Gunasaikiran/FSS_BASED_ABSORBER/README.md

# FSS Based Absorber
This Project presents a novel design for a 3-D printed conformal absorber
based on frequency selective surface (FSS) concept, which exhibits excellent
broadband performance and flexibility. The absorber incorporates an innovative
design element printed on a PLA dielectric, supported by a perforated substrate and
an air gap, that makes it lightweight while maintaining high absorptivity. Resistive
ink is used to print the design pattern on the PLA substrate and a comprehensive
parametric analysis is carried out through simulation to meticulously evaluate each
design parameter’s impact. The geometry demonstrates a remarkable absorption
bandwidth covering frequencies from 8.5 GHz to 29.2 GHz (having a fractional
bandwidth of 109.81%), with absorption levels consistently exceeding 90%. The
design offers broad coverage, spanning the X, Ku, and K bands, and exhibits
polarization insensitivity, ensuring effectiveness across various incident wave
polarizations. Additionally, the absorber remains stable under oblique incidence for
both transverse electric (TE) and transverse magnetic (TM) modes up to 45 degrees
of incident angle, making it ideal for a range of practical applications that require
conformal and flexible electromagnetic absorption. An equivalent circuit model is
created as well as surface current distributions are studied to understand the
mechanism of the proposed absorber in detail. Finally, the absorber has been
fabricated using a low-cost 3-D printing technology and the measured results has
been demonstrated that aligns well with the simulated ones. <br>

<h4>Softwares Used:</h4>
<li>CST and HFSS: Design and Simulation of Absorber</li>
<li>ADS: Design of Equivalent Circuit</li>
<li>MATLAB: Plotting data</li><br>

1]Circuit Geometry:
<p align="center">
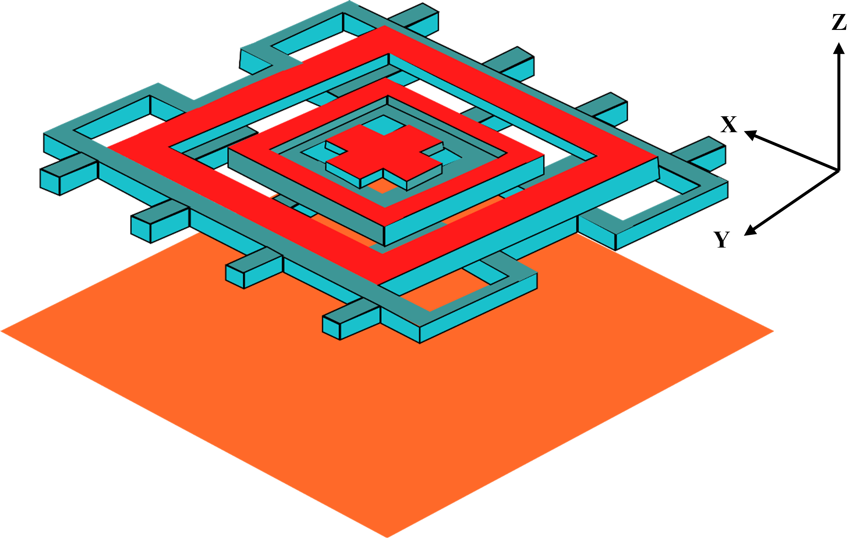
[picture p1: THESIS&PPT/README_PICTURES/3d_with_axis.png]
  
</p>

2]FW:
<p align="center">
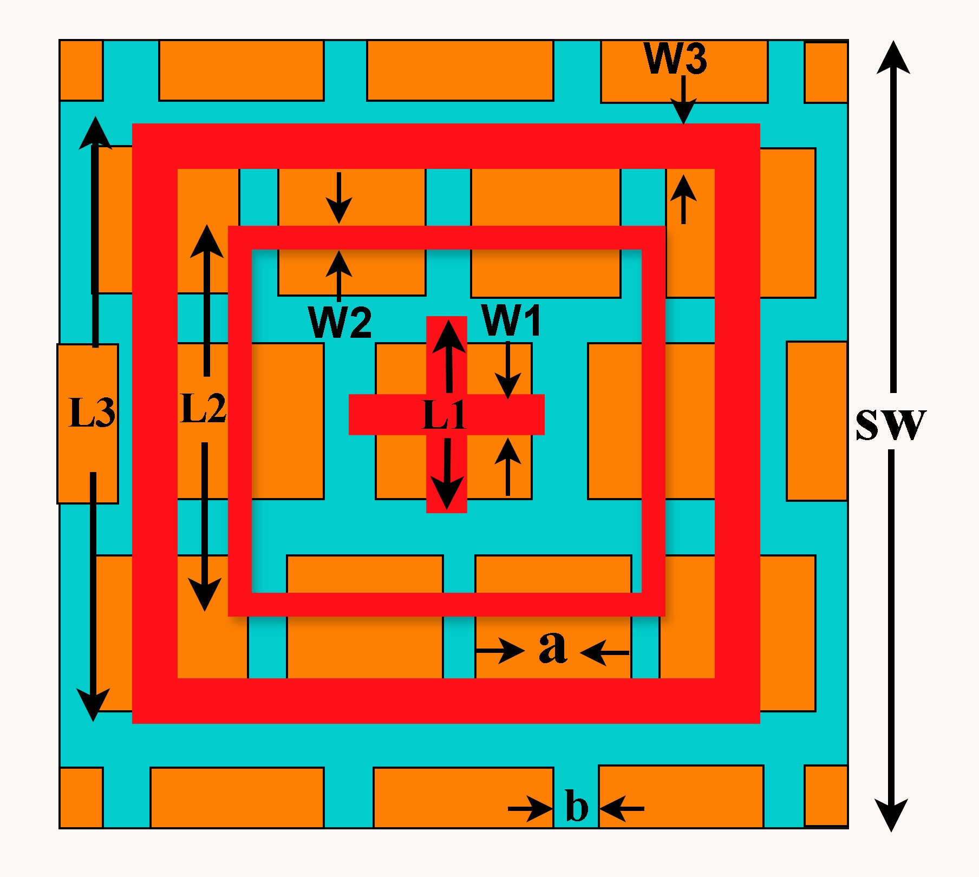
[picture p2: THESIS&PPT/README_PICTURES/FW.jpg]
  
</p>

3]SW:
<p align="center">
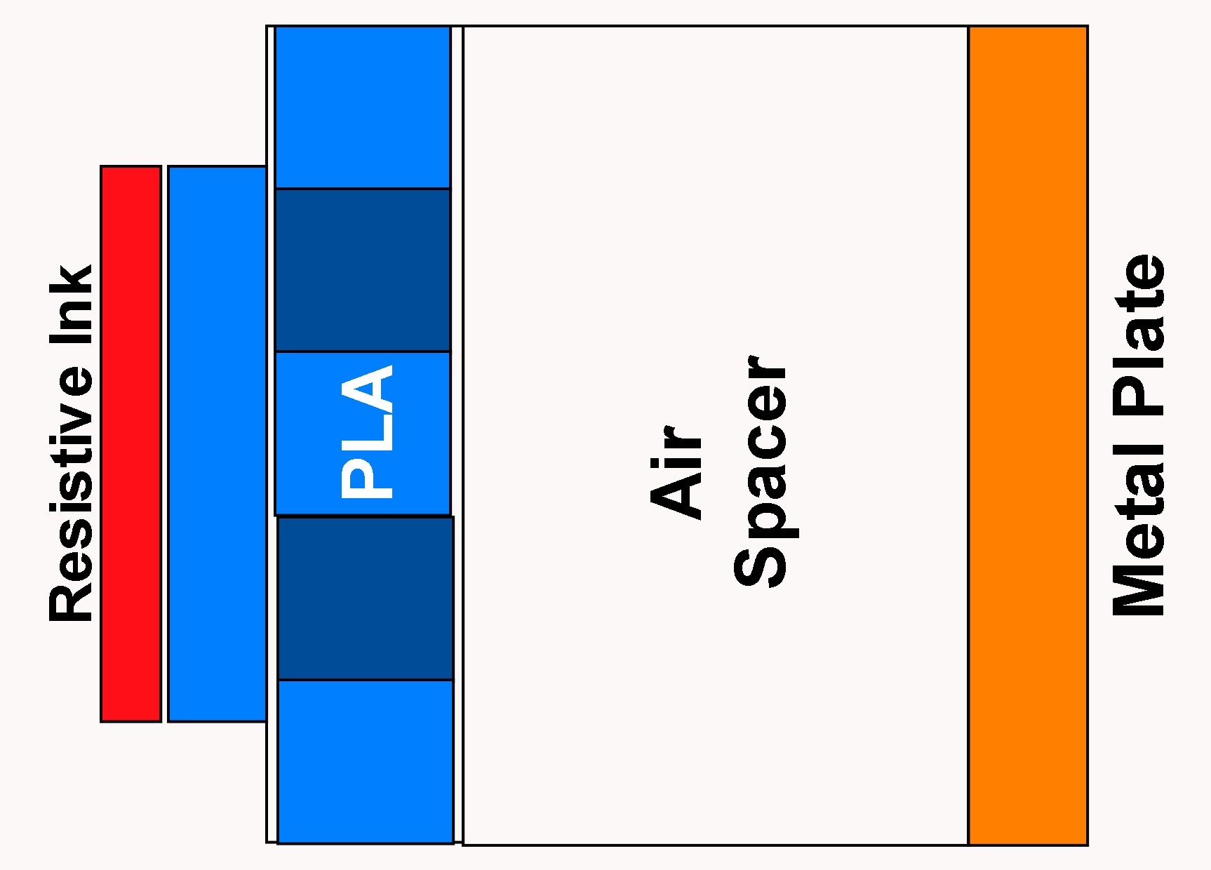
[picture p3: THESIS&PPT/README_PICTURES/It_3(SW).jpg]
  
</p>

4]Cummulative Response:
<p align="center">
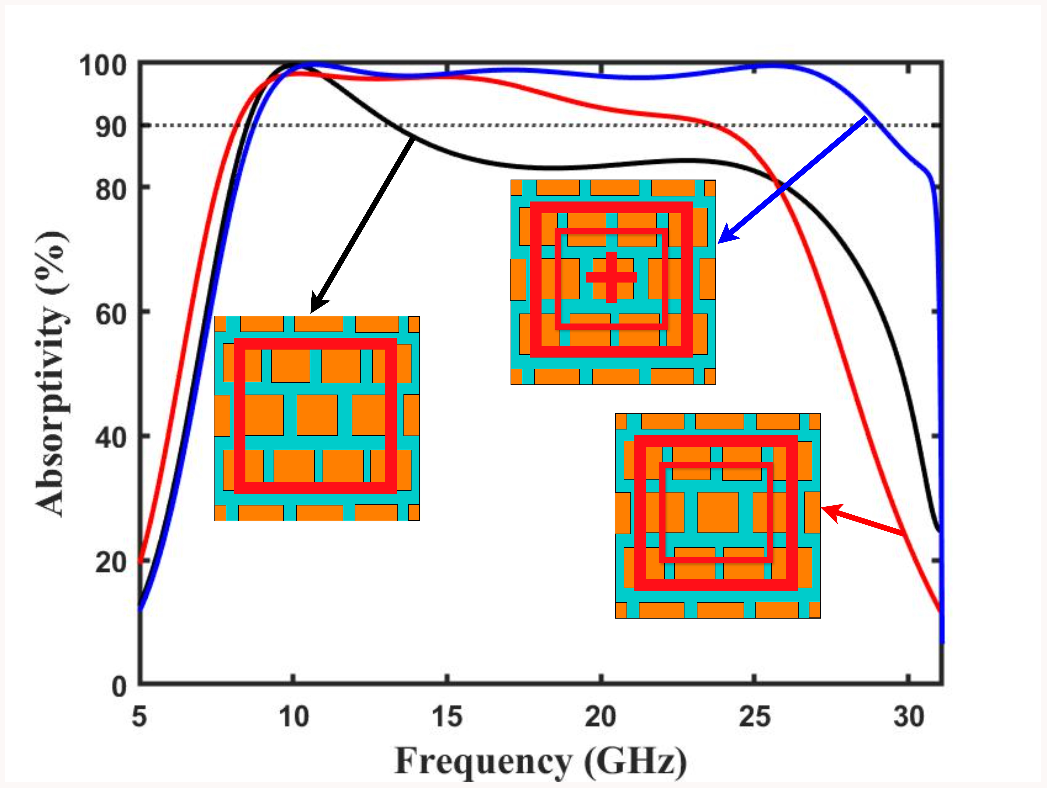
[picture p4: THESIS&PPT/README_PICTURES/Cummulitive_response.jpg]
  
</p>

5]Conformal:
<p align="center">
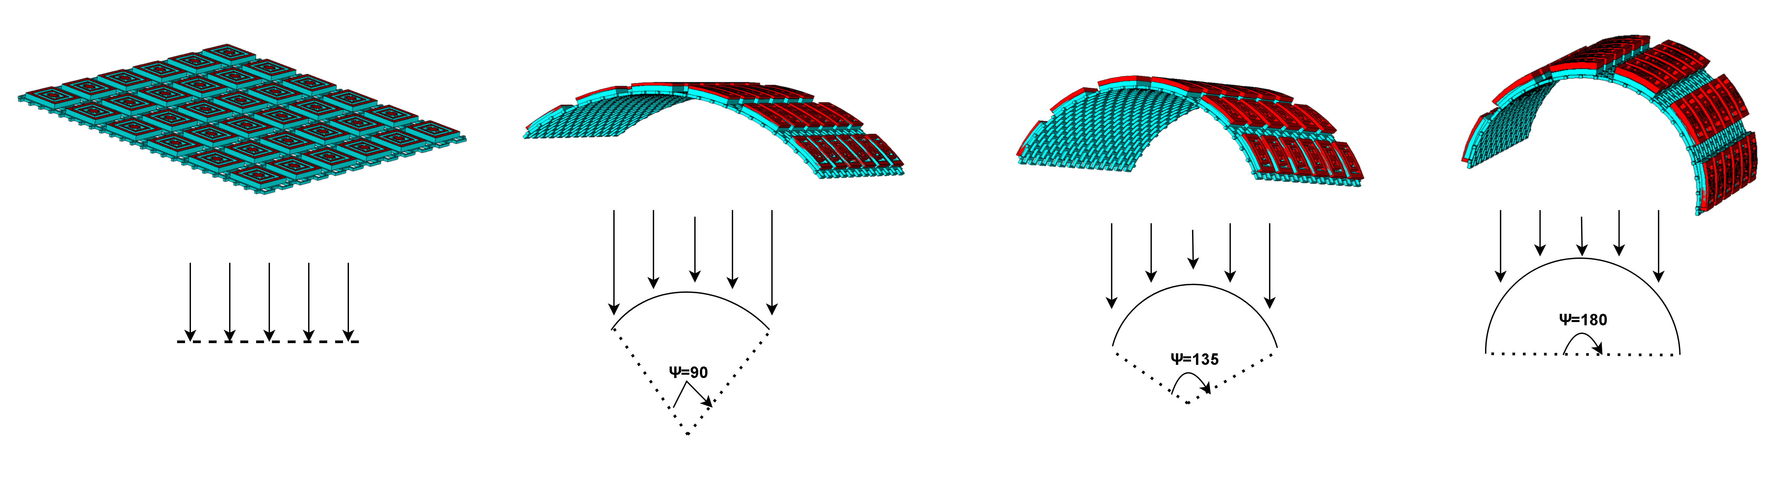
[picture p5: THESIS&PPT/README_PICTURES/Conformal_orie.png]
  
</p>
6]Printing:
<p align="center">
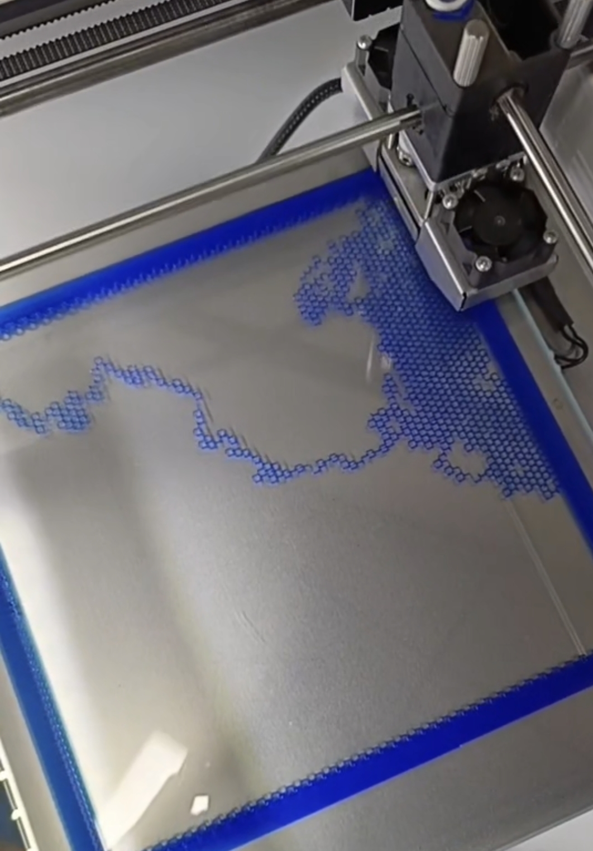
[picture p6: THESIS&PPT/README_PICTURES/Printing.jpg]
  
</p>

7]Fabiricated Pic:
<p align="center">
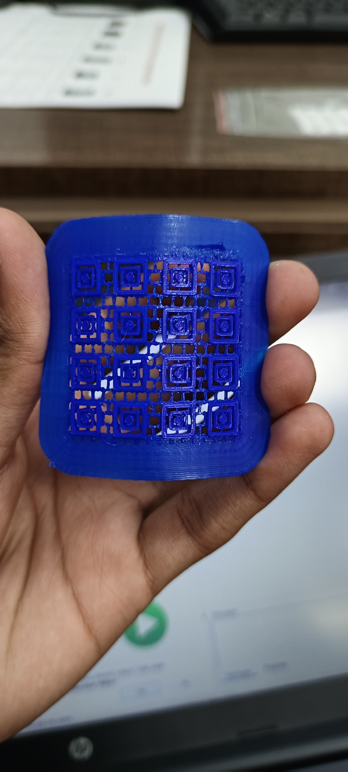
[picture p7: THESIS&PPT/README_PICTURES/fab-2.jpg]
  
</p>

8]Testing:
<p align="center">
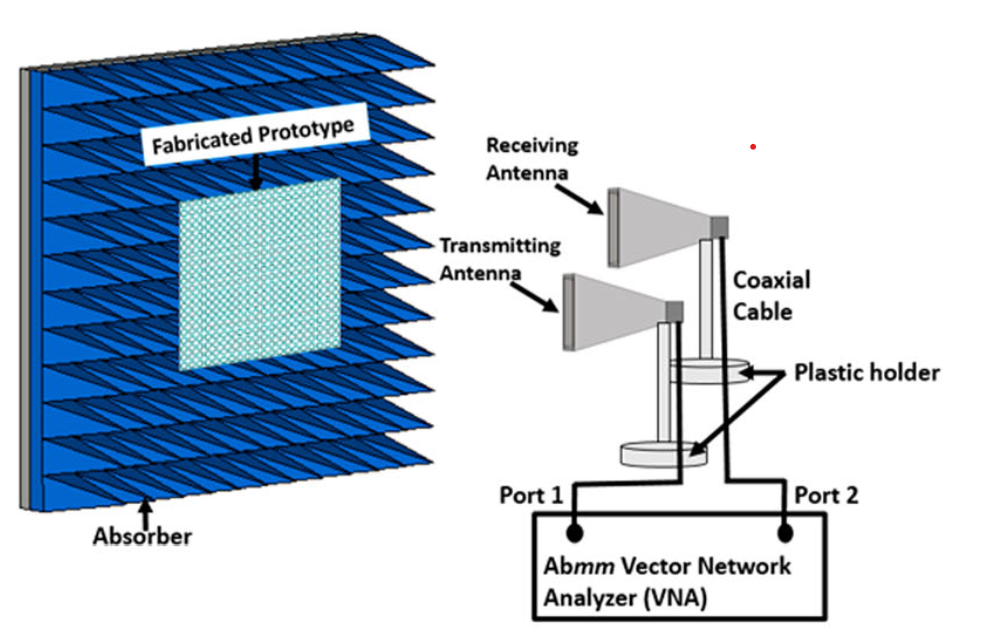
[picture p8: THESIS&PPT/README_PICTURES/Measurment_test.png]
  
</p>
Add a Star 🌟 to this 👆 Repository.<br>
For Sponsor or Project Enquiry
Email - gunasaikiran8055@gmail.com

Follow Me on
LinkedIn - <a href="https://www.linkedin.com/in/guna-sai-kiran-b526a2220/">Guna Sai Kiran</a>
